PingguSoft/B-ROBOT/sch/part_list.xlsx

Sheet: Sheet1
부품 | 규격 | 개수 | 단가 | 합계 | 사이트
CPU 보드 | arduino pro mini | 1 | ₩3630 | ₩3630 | http://roboholic1.godo.co.kr/shop/goods/goods_view.php?goodsno=9677&category=045001
IMU | GY-521 (MPU6050) | 1 | ₩2750 | ₩2750 | http://roboholic1.godo.co.kr/shop/goods/goods_view.php?goodsno=6&category=045006
Stepper Driver | A4988 | 2 | ₩1870 | ₩3740 | http://roboholic1.godo.co.kr/shop/goods/goods_view.php?goodsno=1544&category=050013
WiFi | ESP8266 | 1 | ₩2750 | ₩2750 | http://roboholic1.godo.co.kr/shop/goods/goods_view.php?goodsno=5642&category=054005
NEMA17 | 42x42x40 | 2 | ₩15400 | ₩30800 | http://roboholic1.godo.co.kr/shop/goods/goods_view.php?goodsno=330123&category=050004
 |  |  | ₩13020 | ₩26040 | http://storefarm.naver.com/3d4u/products/424364512
Battery | LiPo 3S, 12V | 1 |  | ₩0
Switch | SPDT 미니 파워 스위치 | 1 | ₩1100 | ₩2200 | http://roboholic1.godo.co.kr/shop/goods/goods_view.php?goodsno=8759&category=060003
만능 기판 | 양면 8x12cm | 1 | ₩1540 | ₩1540 | http://roboholic1.godo.co.kr/shop/goods/goods_view.php?goodsno=329800&category=058004
Servo | Corona DT236MG | 2 |  | ₩0 | optional
 | Digital Metal Gear Park Servo 5.8kg / 0.16sec / 27g |  |  |  |  | Weight (g) | 27
 | D=14, E=40 |  |  |  |  | Torque (kg) | 5.8
 | Dimensions: 28 x 14 x 32mm |  |  |  |  | Speed(Sec/60deg) | 0.16
 | cover:15.5x44 |  |  |  |  | A(mm) | 37
 |  |  |  | ₩42650 |  | B(mm) | 28
 |  |  |  |  |  | C(mm) | 33
 |  |  |  |  |  | D(mm) | 14
부품 | 규격 | 개수 | 단가 | 합계 | 사이트 | E(mm) | 40
CPU 보드 | arduino leonardo R3 | 1 | ₩11000 | ₩11000 | http://www.devicemart.co.kr/1278923 | F(mm) | 22
IMU | GY-521 (MPU6050) | 1 | ₩2700 | ₩2700 | http://www.devicemart.co.kr/1247052
Moror Shield | DRI0023 | 1 | ₩24000 | ₩24000 | http://www.devicemart.co.kr/1163053
WiFi | ESP8266 | 1 | ₩2700 | ₩2700 | http://www.devicemart.co.kr/1279338
DC-DC 컨버터 | LM2596 강하형 DC-DC 가변 | 1 | ₩3000 | ₩3000 | http://www.devicemart.co.kr/1321131
O-ring | AN-152 (d:82.22, h:2.62) 3개/set | 1 | ₩1000 | ₩1000 | http://www.11st.co.kr/product/SellerProductDetail.tmall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
NEMA17 | 42x42x40 | 2 | ₩13020 | ₩26040 | http://storefarm.naver.com/3d4u/products/424364512
Battery | LiPo 3S, 12V | 1 |  | ₩0
Switch | Toggle Switch | 1 |  | ₩0
Servo | MG-90S | 1 | ₩2690 | ₩2690
 |  |  |  | ₩73130
부품 | 규격 | 개수 | 단가 | 합계 | 사이트 | E(mm) | 40
CPU 보드 | arduino uno R3 | 1 | ₩6300 | ₩6300 | http://www.devicemart.co.kr/1245596 | F(mm) | 22
IMU | GY-521 (MPU6050) | 1 | ₩2700 | ₩2700 | http://www.devicemart.co.kr/1247052
Moror Shield | DRI0023 | 1 | ₩24000 | ₩24000 | http://www.devicemart.co.kr/1163053
WiFi | ESP8266 | 1 | ₩2700 | ₩2700 | http://www.devicemart.co.kr/1279338
DC-DC 컨버터 | LM2596 강하형 DC-DC 가변 | 1 | ₩3000 | ₩3000 | http://www.devicemart.co.kr/1321131
O-ring | AN-152 (d:82.22, h:2.62) 3개/set | 1 | ₩1000 | ₩1000 | http://www.11st.co.kr/product/SellerProductDetail.tmall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
NEMA17 | 42x42x40 | 2 | ₩13020 | ₩26040 | http://storefarm.naver.com/3d4u/products/424364512
Battery | LiPo 3S, 12V | 1 |  | ₩0
Switch | Toggle Switch | 1 |  | ₩0
Servo | MG-90S | 1 | ₩2690 | ₩2690
 |  |  |  | ₩68430
 |  |  |  |  | http://jjrobots.com/b-robot-evo-kit-assembly-instructions/
 |  |  |  |  | http://jjrobots.com/projects-2/b-robot/
 |  |  |  |  | https://github.com/jjrobots/B-ROBOT

Sheet: Sheet3
부품 | 규격 | 개수 | 단가 | 합계
CPU 보드 | arduino uno R3 | 1 | ₩6300 | ₩6300
IMU | GY-521 (MPU6050) | 1 | ₩2700 | ₩2700
Moror Shield | DRI0023 | 1 | ₩24000 | ₩24000
WiFi | ESP8266 | 1 | ₩2700 | ₩2700
DC-DC 컨버터 | LM2596 강하형 DC-DC 가변 | 1 | ₩3000 | ₩3000
O-ring | AN-152 (d:82.22, h:2.62) 3개/set | 1 | ₩1000 | ₩1000
NEMA17 | 42x42x40 | 2 | ₩13020 | ₩26040
Battery | LiPo 3S, 12V | 1 |  | ₩0
Switch | Toggle Switch | 1 |  | ₩0
Servo | MG-90S | 1 | ₩2690 | ₩2690
 |  |  |  | ₩68430

Sheet: Sheet2
16000000
div | 8 |  |  | min |  |  |  |  |  | max
 |  |  | speed | -500 | 0 | 1 | 2 | 250 |  | 500
factor | 4 |  | steps | -2000 | 0 | 4 | 8 | 1000 |  | 2000
clock | 2000000 |  | counter | -1000 |  | 500000 | 250000 | 2000 |  | 1000
peiod | 5e-07 |  | peiod |  |  | 0.25 | 0.125 | 0.001 |  | 0.0005
div | 1024 |  |  | min |  |  |  |  |  | max
 |  |  | speed | -500 | 0 | 1 | 23 | 250 | … | 500
factor | 46 |  | steps | -23000 | 0 | 46 | 1058 | 11500 |  | 23000
clock | 15625 |  | counter | -0.6793478261 |  | 339.673913 | 14.768431 | 1.358695652 |  | 0.6793478261
peiod | 6.4e-05 |  | peiod |  |  | 0.02173913043 | 0.0009451795841 | 8.695652174e-05 |  | 4.347826087e-05
0.0163 | 254.6875
 | 0.016384 | 0.032
 | PWM | 0 | 500 | 1000 | 1500 | 2000 | 16384
 | OCR | 0 |  |  |  |  | 256
 |  |  | 7.8125 | 15.625 | 23.4375 | 31.25
 |  |  | 0.0005 | 0.001 | 0.0015 | 0.002
 |  |  | V | mA
R | R1 | 40
 | R2 | 20
 | Vref | 12.6 | 4.2 | 0.21
 |  | 13.2 | 4.4 | 0.22
 |  | 15 | 5
millis
TIME0
div 64
