PingguSoft/B-ROBOT/stl/war_arm_mace_mg90s.stl

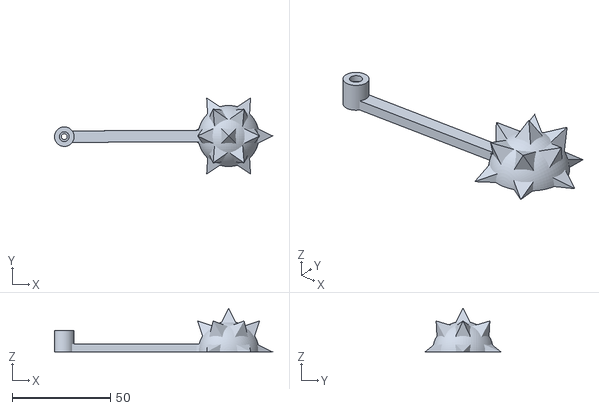
[picture p1: CAD file, 2016-09-19]
stl/war_arm_mace_mg90s.stl
111.2 x 38.8 x 22.4
