PingguSoft/B-ROBOT/stl/regular_arm_mg90s.stl

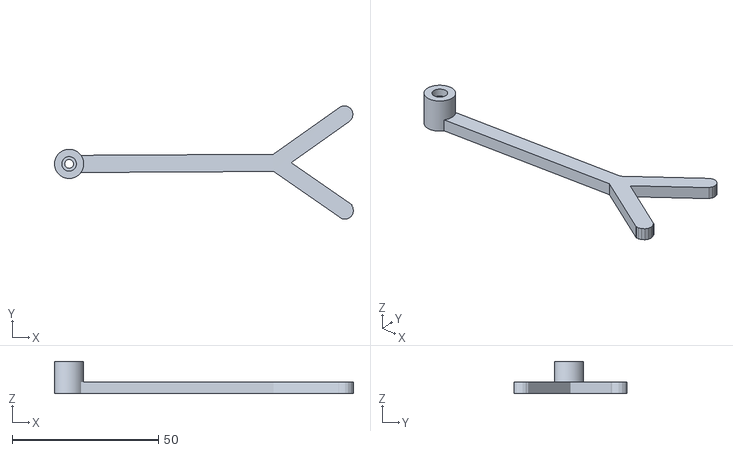
[picture p2: CAD file, 2016-09-19]
stl/regular_arm_mg90s.stl
102.3 x 38.8 x 11.0
