PingguSoft/B-ROBOT/stl/war_arm_axe_mg90s.stl

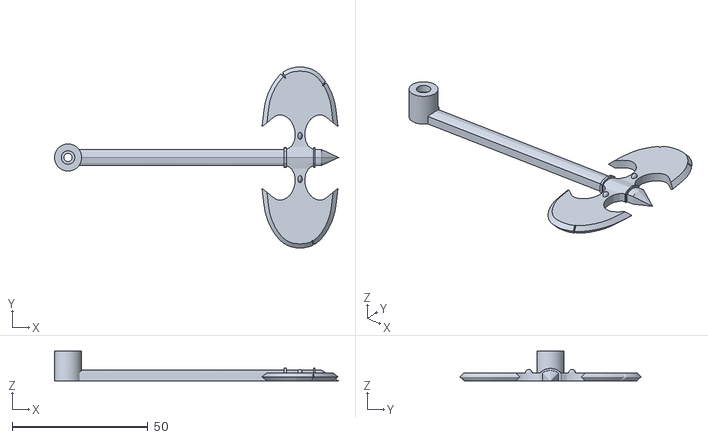
[picture p3: CAD file, 2016-09-19]
stl/war_arm_axe_mg90s.stl
104.7 x 66.9 x 11.0
