PingguSoft/B-ROBOT/stl/regular arm_part.stl

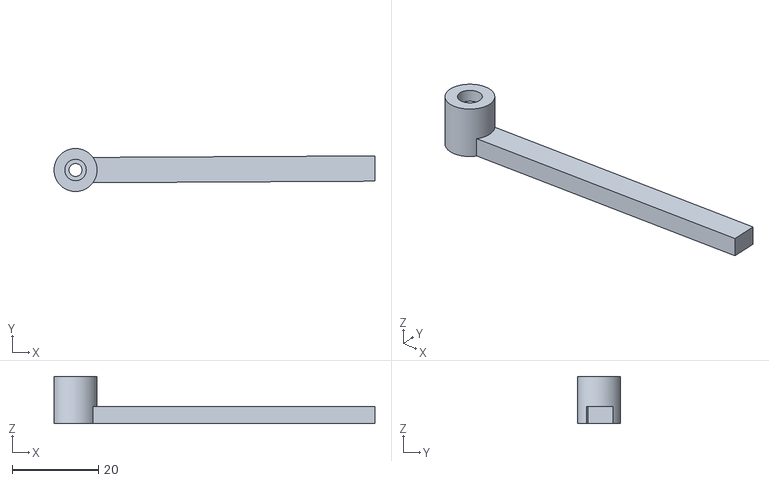
[picture p4: CAD file, 2016-09-19]
stl/regular arm_part.stl
74.6 x 9.99 x 11.0
