PingguSoft/B-ROBOT/stl/war_arm_mace_head.stl

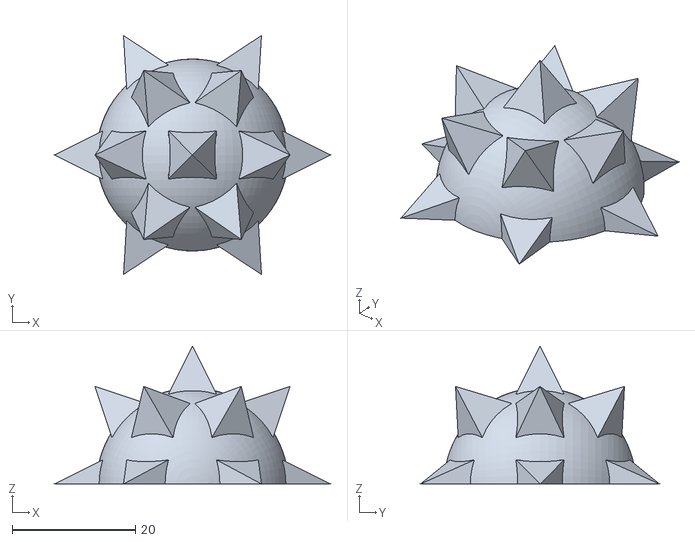
[picture p5: CAD file, 2016-09-19]
stl/war_arm_mace_head.stl
44.8 x 38.8 x 22.4
