PingguSoft/B-ROBOT/stl/war_arm_ring.stl

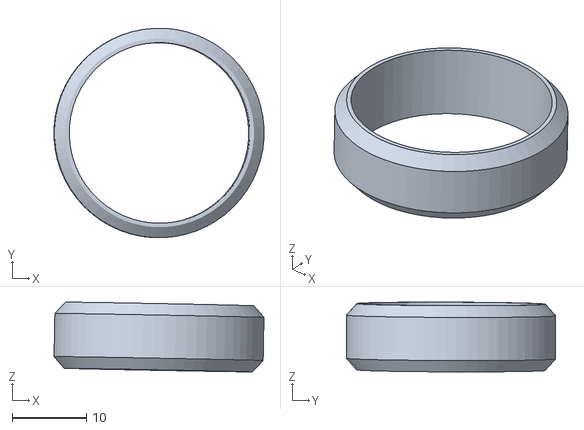
[picture p6: CAD file, 2016-09-10]
stl/war_arm_ring.stl
28.3 x 28.2 x 9.40
