PingguSoft/B-ROBOT/stl/top SHELF.stl

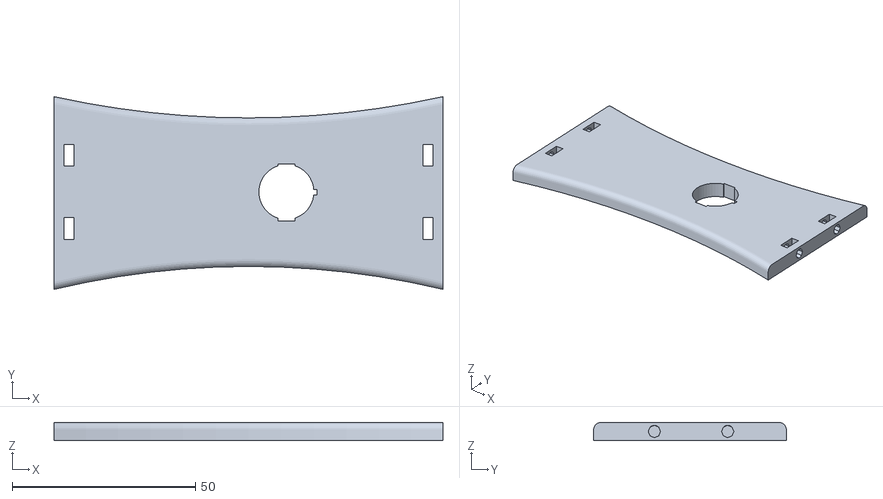
[picture p7: CAD file, 2016-09-04]
stl/top SHELF.stl
106.1 x 52.6 x 5.00
