PingguSoft/B-ROBOT/stl/motor SHELF.stl

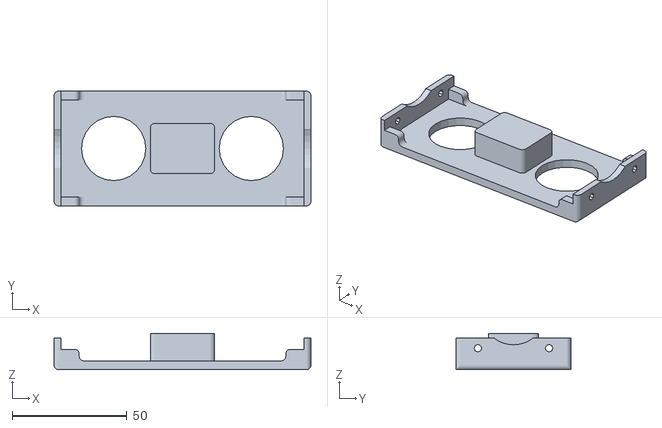
[picture p8: CAD file, 2016-09-04]
stl/motor SHELF.stl
112.0 x 50.0 x 15.9
