PingguSoft/B-ROBOT/stl/Regular Wheel.stl

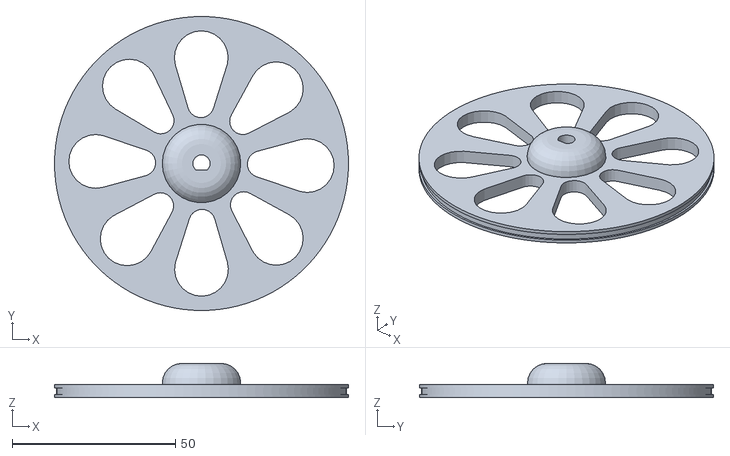
[picture p9: CAD file, 2016-09-04]
stl/Regular Wheel.stl
90.0 x 90.0 x 10.5
