PingguSoft/B-ROBOT/stl/Electronics SHELF.stl

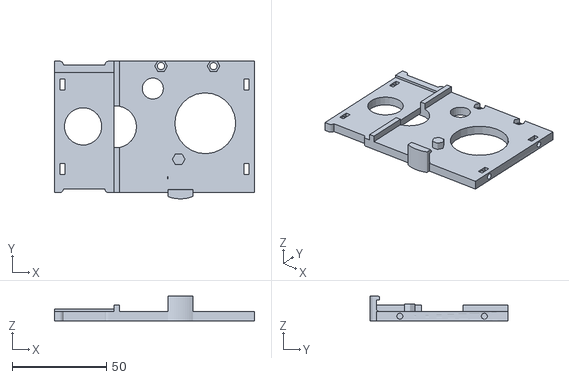
[picture p10: CAD file, 2016-09-04]
stl/Electronics SHELF.stl
106.2 x 73.1 x 13.2
