PingguSoft/B-ROBOT/stl/regular ARM.stl

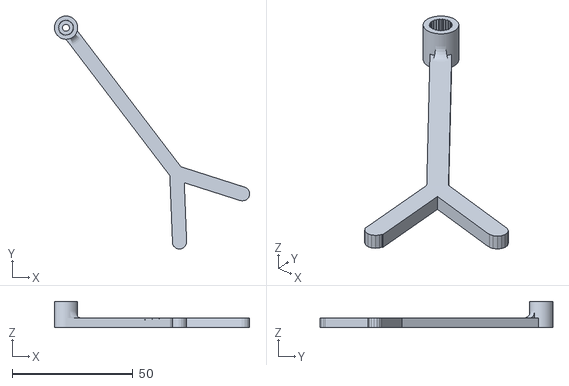
[picture p11: CAD file, 2016-09-04]
stl/regular ARM.stl
80.9 x 96.6 x 10.9
