PingguSoft/B-ROBOT/stl/Lateral.stl

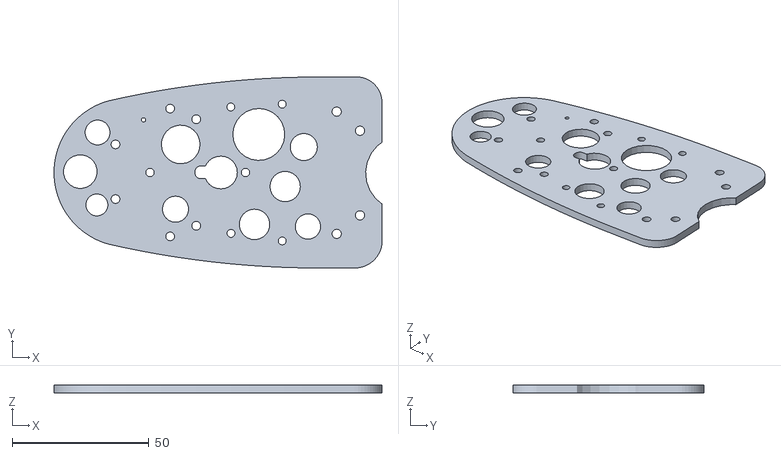
[picture p12: CAD file, 2016-09-04]
stl/Lateral.stl
120.1 x 70.0 x 3.00
