PingguSoft/B-ROBOT/stl/servo holder.stl

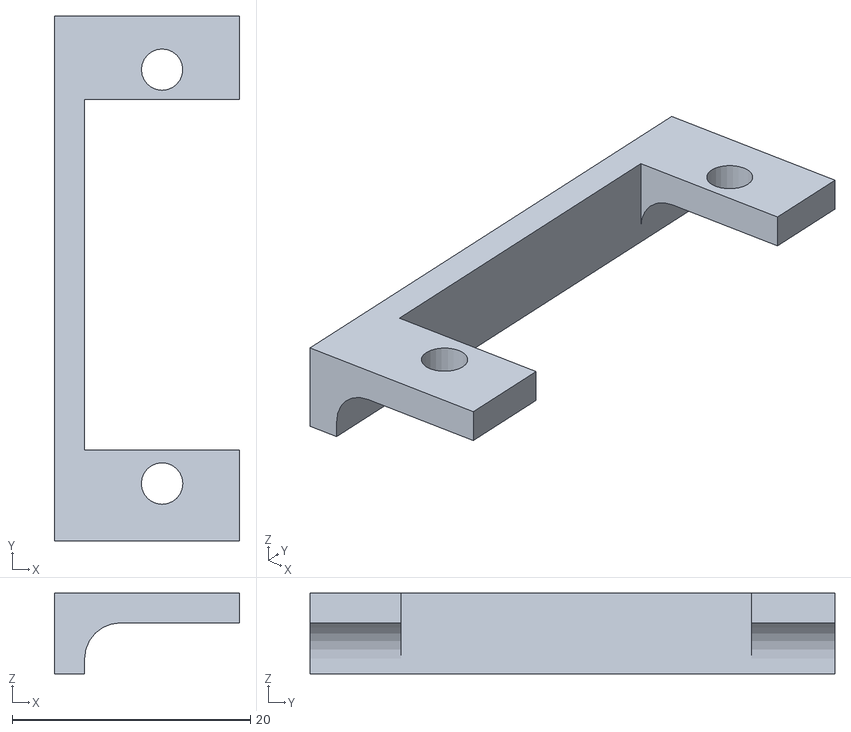
[picture p13: CAD file, 2016-09-04]
stl/servo holder.stl
15.5 x 44.0 x 6.78
