PingguSoft/B-ROBOT/stl/Bumper.stl

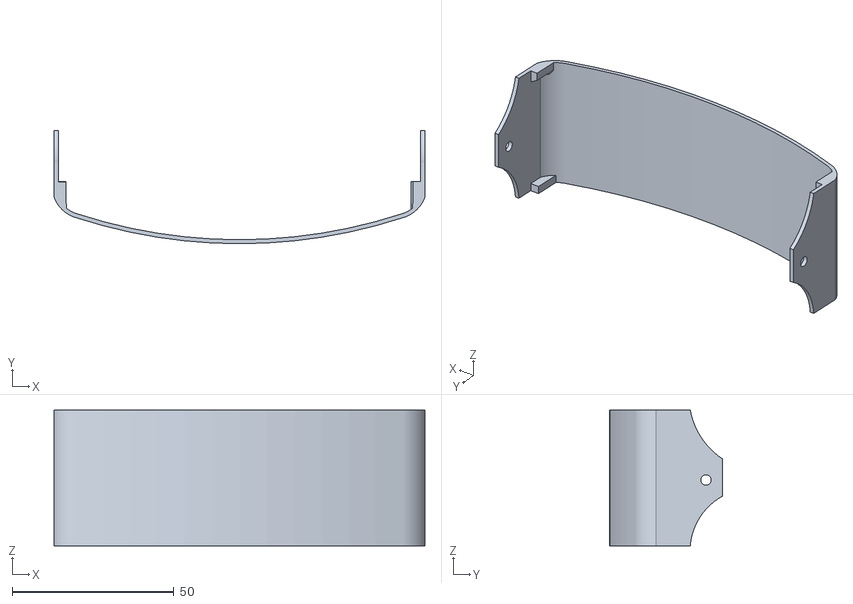
[picture p14: CAD file, 2016-09-04]
stl/Bumper.stl
114.5 x 35.0 x 41.9
