PingguSoft/B-ROBOT/sch/jjrobot/brobot.pdf

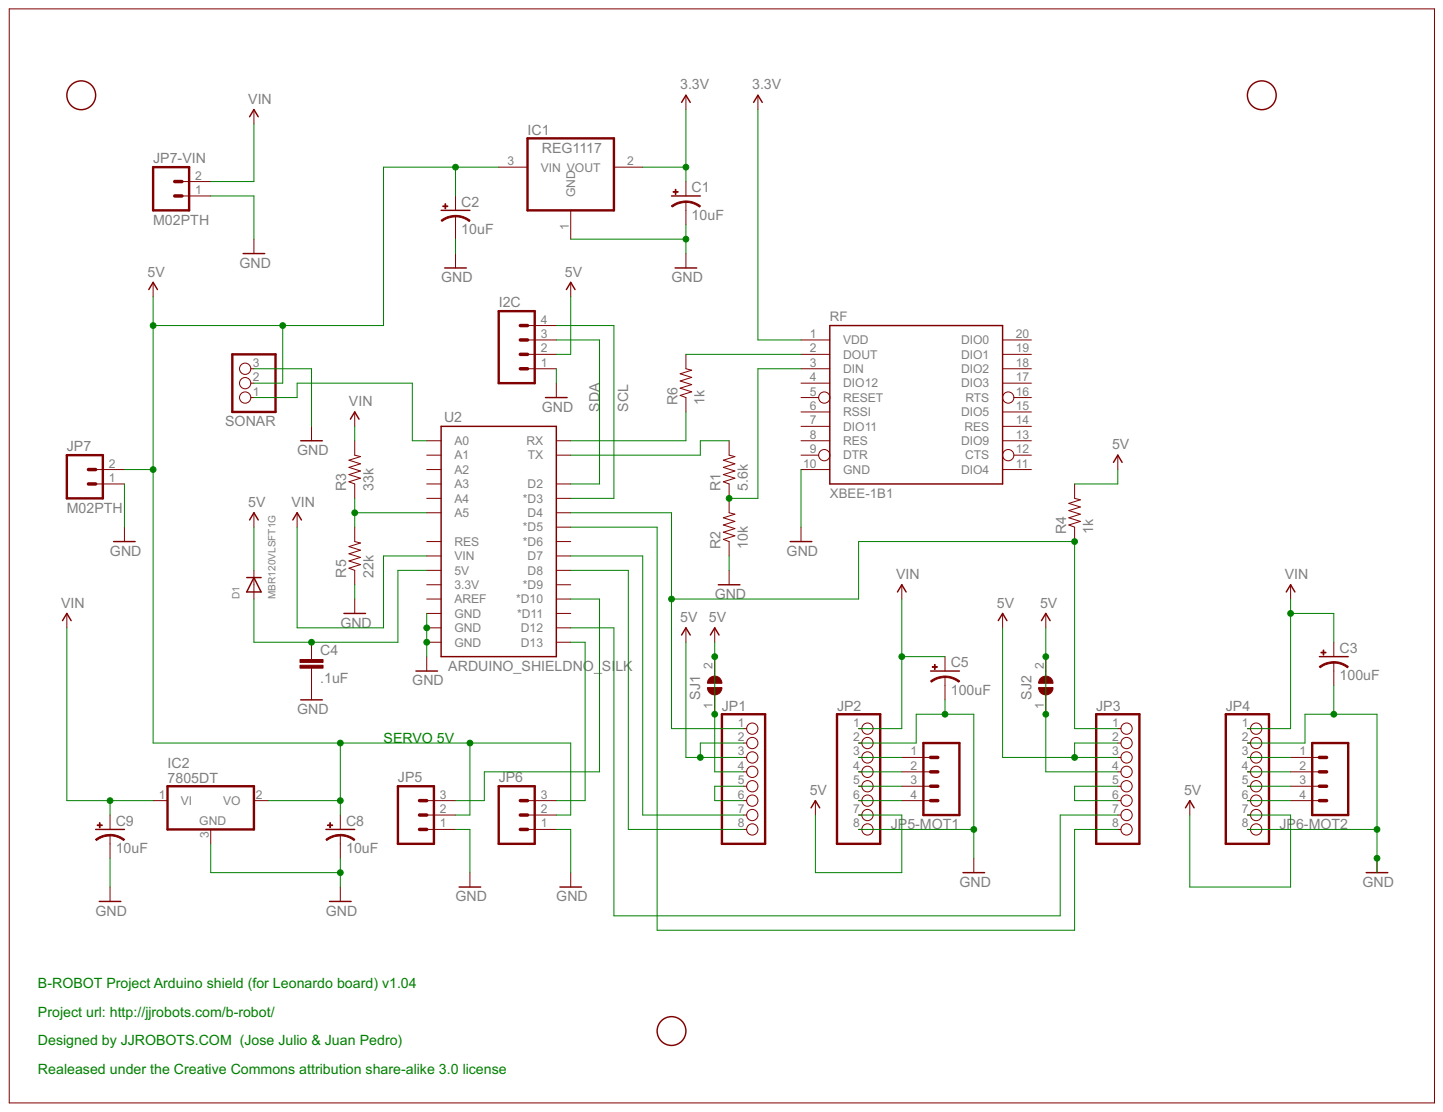
[picture p15: page 1]

B-ROBOT Project Arduino shield (for Leonardo board) v1.04

Project url: http://jjrobots.com/b-robot/

Designed by JJROBOTS.COM (Jose Julio & Juan Pedro)

Realeased under the Creative Commons attribution share-alike 3.0 license
