PingguSoft/B-ROBOT/sch/jjrobot/brobot.sch

## EAGLE design sch/jjrobot/brobot.sch (2016-09-04)

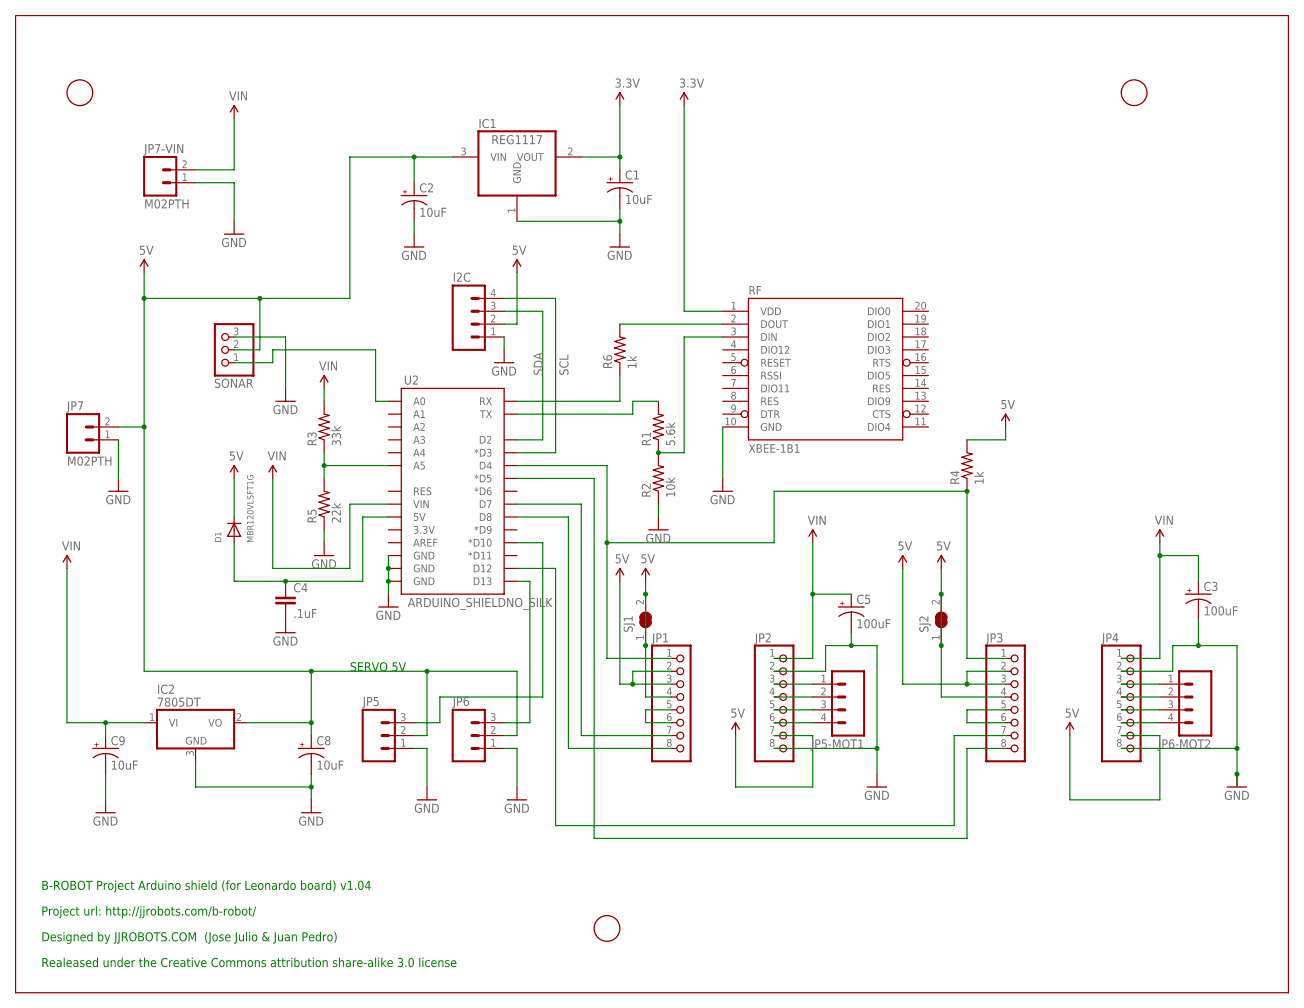
[picture p16: schematic brobot.sch]

Parts:
C1, C2, C8, C9: 10uF; EIA3216
C3, C5: 100uF; PANASONIC_D
C4: .1uF; 0402-CAP
D1: MBR120VLSFT1G; SOD-123
I2C: M04PTH; 1X04
IC1: REG1117; SOT223
IC2: 7805DT; TO252
JP1, JP2, JP3, JP4: PINHD-1X8; 1X08
JP5, JP6: M03PTH; 1X03
JP5-MOT1, JP6-MOT2: M04PTH; 1X04
JP7, JP7-VIN: M02PTH; 1X02
R1: 5.6k; 0805
R2: 10k; 0805
R3: 33k; 0805
R4, R6: 1k; 0805
R5: 22k; 0805
RF: XBEE-1B1; XBEE-1
SJ1, SJ2: SJW
SONAR: PINHD-1X3; 1X03
U2: ARDUINO_SHIELDNO_SILK; DUEMILANOVE_VIAS
U$1, U$2, U$3: FIDUCIAL; FIDUCIAL_1MM

Connections:
3.3V: C1.A (+), IC1.2 (VOUT), RF.1 (VDD)
5V: C2.A (+), C8.A (+), D1.C, I2C.2, IC1.3 (VIN), IC2.2 (VO), JP1.2, JP1.3, JP1.4, JP2.7, JP3.2, JP3.3, JP3.4, JP4.7, JP5.2, JP6.2, JP7.2, R4.2, SJ1.1, SJ1.2, SJ2.1, SJ2.2, SONAR.2
GND: C1.C (-), C2.C (-), C3.-, C4.2, C5.-, C8.C (-), C9.C (-), I2C.1, IC1.1 (GND), IC2.3 (GND), JP2.2, JP2.8, JP4.2, JP4.8, JP5.1, JP6.1, JP7.1, JP7-VIN.1, R2.1, R5.1, RF.10 (GND), SONAR.3, U2.GND@0 (GND), U2.GND@1 (GND), U2.GND@2 (GND)
unnamed: JP2.3, JP5-MOT1.1
unnamed: JP2.4, JP5-MOT1.2
unnamed: R6.2, RF.2 (DOUT)
unnamed: R1.1, R2.2, RF.3 (DIN)
unnamed: R1.2, U2.TX
unnamed: JP2.5, JP5-MOT1.3
unnamed: JP2.6, JP5-MOT1.4
unnamed: JP4.3, JP6-MOT2.1
unnamed: JP4.4, JP6-MOT2.2
unnamed: JP4.5, JP6-MOT2.3
unnamed: JP1.5, JP1.6
unnamed: JP3.5, JP3.6
unnamed: R3.1, R5.2, U2.A5
unnamed: R6.1, U2.RX
unnamed: SONAR.1, U2.A0
unnamed: JP4.6, JP6-MOT2.4
unnamed: JP6.3, U2.D13
unnamed: JP5.3, U2.D10 (*D10)
unnamed: JP1.8, U2.D8
unnamed: JP1.7, U2.D7
unnamed: JP1.1, JP3.1, R4.1, U2.D4
unnamed: JP3.8, U2.D5 (*D5)
unnamed: JP3.7, U2.D12
unnamed: C4.1, D1.A, U2.5V
SCL: I2C.4, U2.D3 (*D3)
SDA: I2C.3, U2.D2
VIN: C3.+, C5.+, C9.A (+), IC2.1 (VI), JP2.1, JP4.1, JP7-VIN.2, R3.2, U2.VIN

Notes on the sheet:
SERVO 5V
Project url: http://jjrobots.com/b-robot/
Designed by JJROBOTS.COM (Jose Julio & Juan Pedro)
Realeased under the Creative Commons attribution share-alike 3.0 license
B-ROBOT Project Arduino shield (for Leonardo board) v1.04
