PingguSoft/B-ROBOT/b-robot/RobotAux.cpp

/*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
 This program is distributed in the hope that it will be useful,
 but WITHOUT ANY WARRANTY; without even the implied warranty of
 MERCHANTABILITY or FITNESS FOR A PARTICULAR PURPOSE.  See the
 GNU General Public License for more details.
 see <http://www.gnu.org/licenses/>
*/

#include <stdarg.h>
#include "RobotAux.h"

#define SONAR_BARO_LPF_LC   0.8f

#define SONAR_NO_DETECT     -1
#define SONAR_PROGRESS      -2
#define SONAR_ECHO_DETECT   -3

#if __FEATURE_SONAR__
s16          mDist[2];
volatile s16 mTempDist[2];
u32          mStartTS[2];
u32          mPingTS;
#endif

u8 RobotAux::getBattVolt(void)
{
    u16 v;
    u16 maxVolt;

    v = analogRead(PIN_ANALOG_VOLT);

    mVoltSum += v;
    mVoltSum -= mVoltBuf[mVoltIdx];
    mVoltBuf[mVoltIdx++] = v;
    mVoltIdx %= VBAT_SMOOTH_LEVEL;

    // max volt = ((r1 + r2) / r2) * 5V
    maxVolt = (BATT_DIVIDER_R1 / BATT_DIVIDER_R2) * 50 + 50;
    return map(mVoltSum / VBAT_SMOOTH_LEVEL, 0, 1023, 0, maxVolt - 2);
}

void RobotAux::initServo(void)
{
    pinMode(PIN_SERVO_1, OUTPUT);
    pinMode(PIN_SERVO_2, OUTPUT);

#if defined(__AVR_ATmega328P__)
    // initialize timer2 as Fast PWM (mode3)
    TCCR2A = BV(COM2A1) | BV(COM2B1) | BV(WGM21) | BV(WGM20);
    TCCR2B = BV(CS22) | BV(CS21) | BV(CS20);                    // prescaler = 1024, 16MHz/1024/256 = 61Hz (16.3ms)
    TCNT2  = 0;
#elif defined(__AVR_ATmega32U4__)
    // initialize timer4 as Fast PWM
    TCCR4A = BV(COM4A1) | BV(COM4B1) | BV(PWM4A) | BV(PWM4B);
    TCCR4B = BV(CS43) | BV(CS41) | BV(CS40);                    // prescaler = 1024, 16MHz/1024/256 = 61Hz (16.3ms)
    TCCR4D = 0;
    TCCR4E = 0;
    TC4H   = 0;
    TCNT4  = 0;
#endif

    moveServo(0, 1500);
    moveServo(1, 1500);
}

void RobotAux::moveServo(u8 idx, u16 pwm)
{
    u8 ocr = map(pwm, 0, 16384, 0, 256);

    if (idx == 0) {
#if defined(__AVR_ATmega328P__)
        OCR2B = ocr;
#elif defined(__AVR_ATmega32U4__)
        OCR4A = ocr;
#endif
    } else {
#if defined(__AVR_ATmega328P__)
        OCR2A = ocr;
#elif defined(__AVR_ATmega32U4__)
        TC4H  = 0;
        OCR4B = ocr;
#endif
    }
}

void RobotAux::begin(void)
{
    initServo();

    for (u8 i = 0; i < VBAT_SMOOTH_LEVEL; i++)
        getBattVolt();

#if __FEATURE_SONAR__
    mDist[0] = SONAR_NO_DETECT;
    mDist[1] = SONAR_NO_DETECT;

    pinMode(PIN_SONAR_TRIG, OUTPUT);
    pinMode(PIN_SONAR_ECHO_1, INPUT);
    pinMode(PIN_SONAR_ECHO_2, INPUT);
    digitalWrite(PIN_SONAR_TRIG, LOW);

    PCINT_ECHO_MASK |=  (BV(BIT_SONAR_ECHO_1) | BV(BIT_SONAR_ECHO_2));
    PCICR = PCICR | PCINT_ECHO_IR_BIT;
#endif
}

void RobotAux::updateSonar(void)
{
    s16 dist;

#if __FEATURE_SONAR__
    if (micros() - mPingTS > 50000) {
        for (u8 i = 0; i < 2; i++) {
            if (mTempDist[i] < 0) {
                dist = mDist[i];
            } else {
                dist = mTempDist[i];
            }
            mDist[i] = dist; //(mDist[i] * SONAR_BARO_LPF_LC) + (mTempDist[i] * (1 - SONAR_BARO_LPF_LC));
            mTempDist[i] = SONAR_NO_DETECT;
        }
        mPingTS = micros();
        digitalWrite(PIN_SONAR_TRIG, LOW);
        delayMicroseconds(2);
        digitalWrite(PIN_SONAR_TRIG, HIGH);
        delayMicroseconds(10);
        digitalWrite(PIN_SONAR_TRIG, LOW);
    }
#endif
}

s16 RobotAux::getDist(u8 idx)
{
#if __FEATURE_SONAR__
    return mDist[idx];
#else
    return -1;
#endif
}

#if __FEATURE_SONAR__
ISR(PCINT_ECHO)
{
    static u8 ucLastPin;

    u8 pins = PCINT_ECHO_PINS;
    u8 mask = pins ^ ucLastPin;

    if (mask & BV(BIT_SONAR_ECHO_1)) {
        if (pins & BV(BIT_SONAR_ECHO_1)) {
            mStartTS[0]  = micros();
            mTempDist[0] = SONAR_ECHO_DETECT;
        } else {
            mTempDist[0] = (micros() - mStartTS[0]) / 58;
        }
    }

    if (mask & BV(BIT_SONAR_ECHO_2)) {
        if (pins & BV(BIT_SONAR_ECHO_2)) {
            mStartTS[1]  = micros();
            mTempDist[1] = SONAR_ECHO_DETECT;
        } else {
            mTempDist[1] = (micros() - mStartTS[1]) / 58;
        }
    }
    ucLastPin = pins;
}
#endif
