PingguSoft/B-ROBOT/(commit log)

2016-09-04 initial update
    [Bumper.stl, Electronics SHELF.stl, Lateral.stl, Regular Wheel.stl, brobot.brd, brobot.sch, motor SHELF.stl, part_list.xlsx]
2016-09-05 schematic for arduino pro mini updated
    [brobot.sch, brobot_pro_mini.sch, part_list.xlsx]
2016-09-06 b-robot testing
    [part_list.xlsx]
2016-09-06 Timer0 conflicts with millis, Timer1 for millis
    [part_list.xlsx]
2016-09-07 working version
    timer1 and timer2 used for motor control because timer0 is used for
    millis
2016-09-08 battery monitor implementation
    [brobot_pro_mini.sch, part_list.xlsx]
2016-09-08 battery monitor and sonar integration
2016-09-09 sonar and servo supported
2016-09-10 servo motor control with throttle stick
    [Bumper.stl, Electronics SHELF.stl, Lateral.stl, Regular Wheel.stl, brobot.brd, brobot.sch, motor SHELF.stl, regular ARM.stl]
2016-09-13 codes cleanup
    [part_list.xlsx]
2016-09-19 ARMs for MG90S added
    [part_list.xlsx, regular ARM_mod.stl, regular arm_mod_mg90s.stl, regular arm_part.stl, regular_arm_mg90s.stl, war_arm_axe_mg90s.stl, war_arm_mace.stl, war_arm_mace_head.stl]
2016-09-20 esp8266 at command processor added
    [brobot_pro_mini.sch, part_list.xlsx]
2016-09-22 uno, leonardo, pro mini supported
    esp8266 default mode support
    [brobot.sch]
2016-09-22 batt voltage divider resistors added
    R1, R2 added
    [part_list.xlsx]
2016-10-14 fix pwm configuration for arduino leonardo servo
    [RobotAux.cpp]
